Eljily-Mohamed/autonomous-sailboat/Arduino/docs/images/Fonctionnement_mux.png

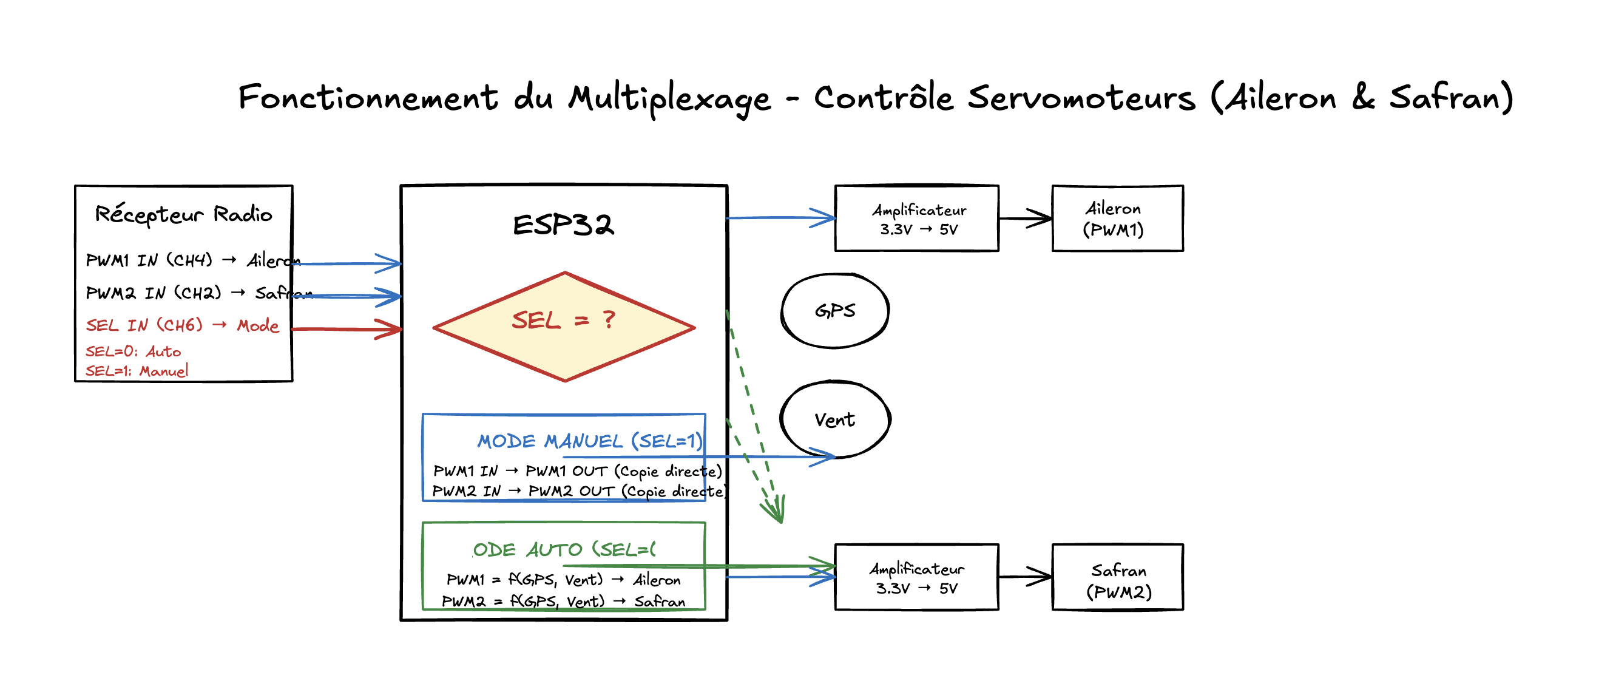
Arduino/docs/images/Fonctionnement_mux.png
