Eljily-Mohamed/autonomous-sailboat/(commit log)

2025-11-26 Complete Arduino projects collection with autonomous sailboat firmware
2025-11-26 Fix: Add boat project files properly (not as submodule)
    [Gps.cpp, Gps.hpp, MotorControl.cpp, MotorControl.hpp, RadioReceiver.cpp, RadioReceiver.hpp, ServoControl.cpp, ServoControl.hpp]
2025-11-26 Configure PWM pins as open-drain for servo and motor control
    - Add OUTPUT_OPEN_DRAIN configuration for SERVO_SAIL_PIN (GPIO 2)
    - Add OUTPUT_OPEN_DRAIN configuration for SERVO_RUDDER_PIN (GPIO 25)
    - Add OUTPUT_OPEN_DRAIN configuration for MOTOR_ESC_PIN (GPIO 4)
    - Update config_pins.h with documentation about open-drain configuration
    - Ensures compatibility with 3.3V→5V amplifiers and ESC controllers
2025-11-26 Add communication scenario to README
    - Add communication channels overview (LoRa, USB, Radio, GPS)
    - Add JSON message format examples
    - Add complete mission scenario with telemetry examples
    - Add hardware pin configuration summary
    - Add emergency intervention procedure
    - Reference to detailed SCENARIO_COMMUNICATION.md file
2025-11-26 Major README enhancement: comprehensive project documentation
    - Add project objectives and technical specifications
    - Include complete hardware requirements table
    - Add quick start guide with installation steps
    - Include real-time telemetry JSON examples
    - Add 37-minute mission scenario summary
    - Include safety and reliability features
    - Add academic context and learning objectives
    - Improve structure with emojis and clear sections
    - Add hardware pin configuration examples
    - Include communication protocols overview
2025-11-26 Add comprehensive system testing scenario to README
    - Add 4-phase testing protocol (65 minutes total)
    - Phase 1: Unit tests (LoRa, Servos, Radio, GPS) - 10 min
    - Phase 2: Integration tests (Communication, Wind, Navigation) - 15 min
    - Phase 3: Robustness tests (Emergency, Error handling, Restart) - 10 min
    - Phase 4: Long duration mission simulation - 30 min
    - Include validation checklist with pass/fail criteria
    - Add performance metrics and failure criteria
    - Provide JSON command examples for each test
    - Include real-time verification steps
2025-11-26 Optimize manual mode: ultra-fast signal copy with offset sensitivity
    - Remove all Serial.println() and debug messages for maximum performance
    - Implement direct PWM signal copy with writeMicroseconds()
    - Add intelligent offset for small variations (< 10µs amplified to 15µs)
    - Disable GPS and telemetry to focus on manual control
    - Increase PWM reading frequency to 20ms (50Hz)
    - Average 3 PWM readings for stability
    - Remove all constraints to preserve original signal
    - CPU 100% dedicated to servo control for fluid response
    [RadioReceiver.cpp, ServoControl.cpp, boat.ino, config_pins.h]
2025-11-26 Perfect servo control: ultra-limited range to prevent multiple turns
    - Calibrate for exact telecommand values: 5.68% (1136µs) to 8.67% (1734µs)
    - Map to ultra-narrow servo range: 1450-1550µs (only 100µs variation)
    - Prevent multiple turns with 83% range reduction
    - Maintain precise control within ~45° movement
    - Adjust dead zone to 10µs for limited range
    - Filter aberrant values for telecommand range 1100-1800µs
    - Perfect single movement control achieved
    [RadioReceiver.cpp, ServoControl.cpp, config_pins.h]
2025-12-03 Fix: Correction détection mode manuel/autonome avec seuil PWM 6% sur pin SEL
    [RadioReceiver.cpp, boat.ino]
2025-12-14 Reorganize project structure: move all Arduino code to Arduino/ folder and create IHM, electronique, ethicotechnique folders
2025-12-17 Add documentation files and Arduino code
